jwkelly49/C-MRI-on-Arduino-Cards/16 Input Card/Arduino Code/ReadMe.txt

Drop this folder into Arduino where you store all of your other ino files. Remember you'll have to download the CMRI and Auto485 libraries to make the file compiled and download.

https://github.com/madleech/Auto485

https://github.com/madleech/ArduinoCMRI

this is a good HELP for installing arduino libraries
https://www.arduino.cc/en/guide/libraries
