jwkelly49/C-MRI-on-Arduino-Cards/8 input 8 output card/Schematic/8 in 8 out schematic.jpg

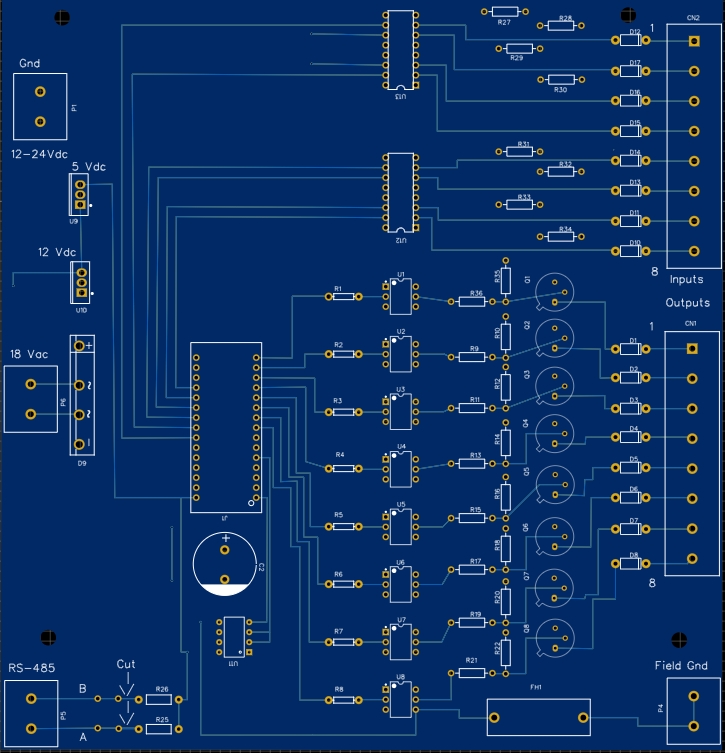
8 input 8 output card/Schematic/8 in 8 out schematic.jpg
