jwkelly49/C-MRI-on-Arduino-Cards/16 Input Card/Schematic/schematic.jpg

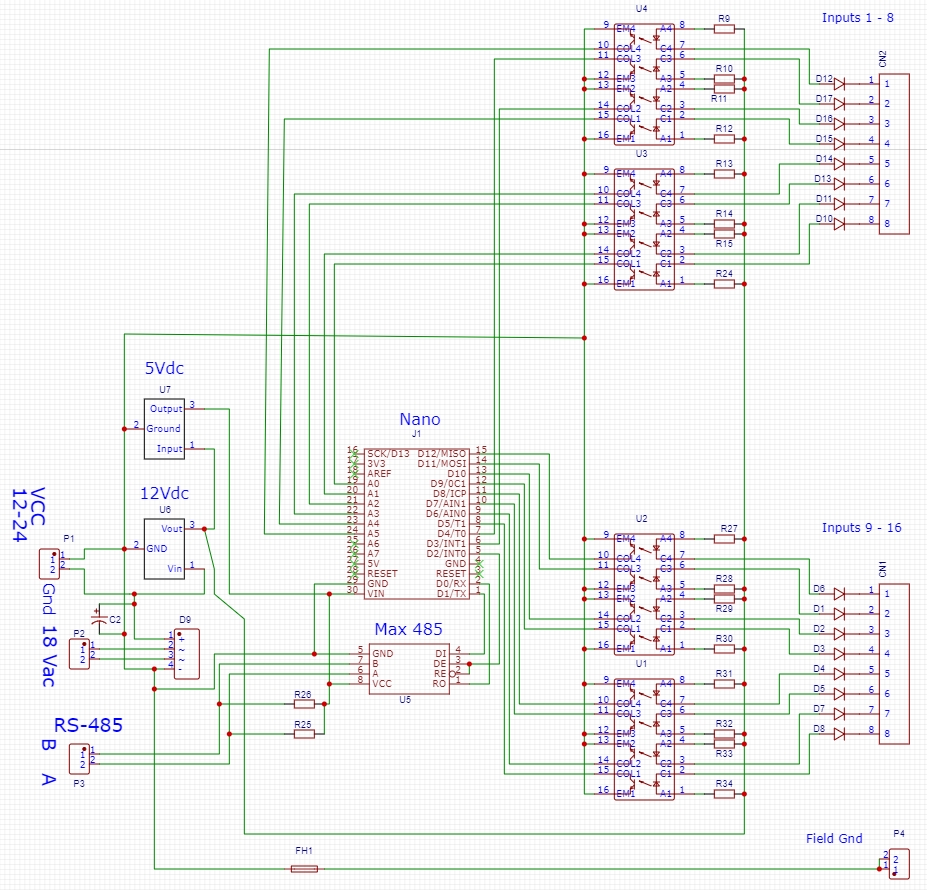
16 Input Card/Schematic/schematic.jpg
