jwkelly49/C-MRI-on-Arduino-Cards/Block Detector/Schematic/block detector.jpg

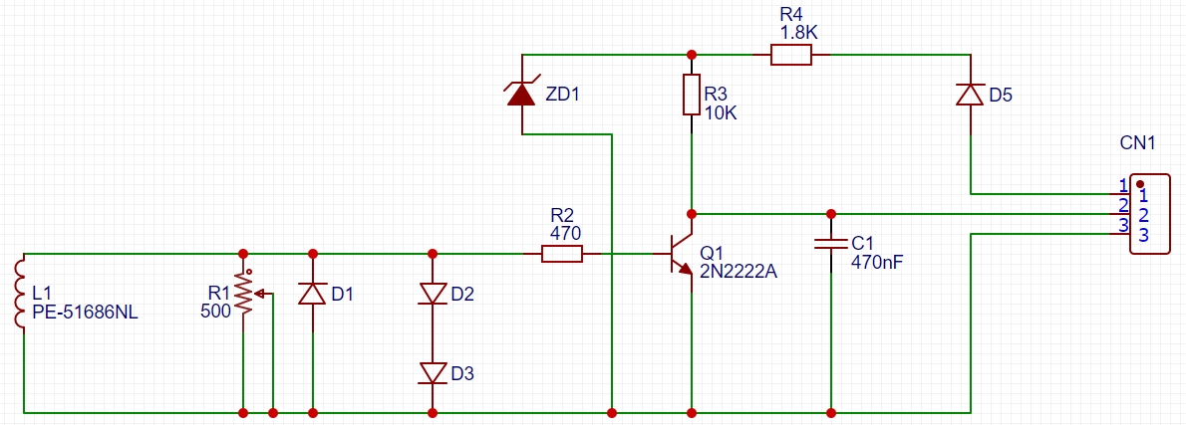
Block Detector/Schematic/block detector.jpg
