jwkelly49/C-MRI-on-Arduino-Cards/Compatible Siding Card/Schematic/pcb 3.jpg

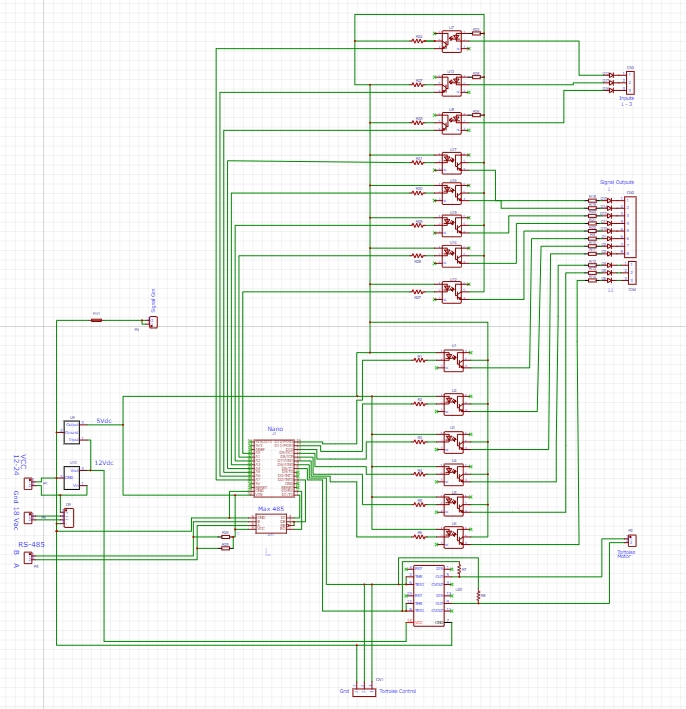
Compatible Siding Card/Schematic/pcb 3.jpg
