jwkelly49/C-MRI-on-Arduino-Cards/holding/power.jpg

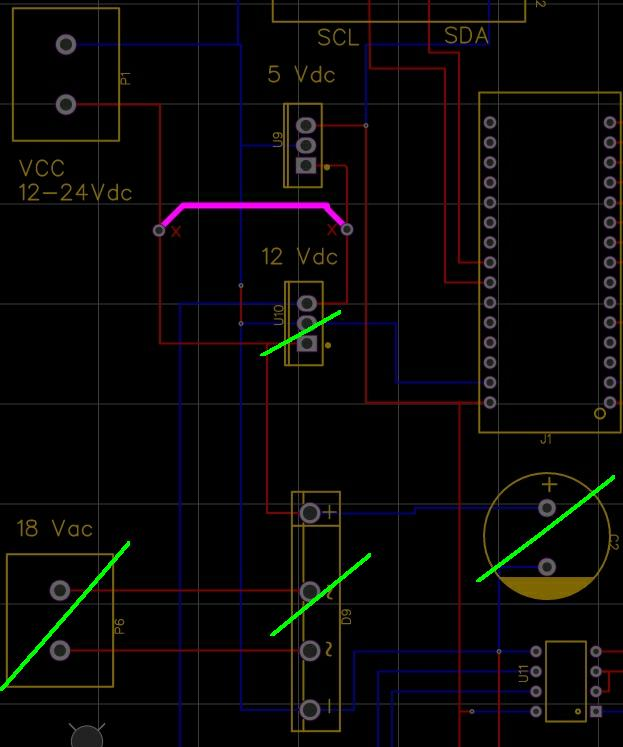
holding/power.jpg
