jwkelly49/C-MRI-on-Arduino-Cards/Tortoise Matrix Setup Card/Schematic/schmatic.jpg

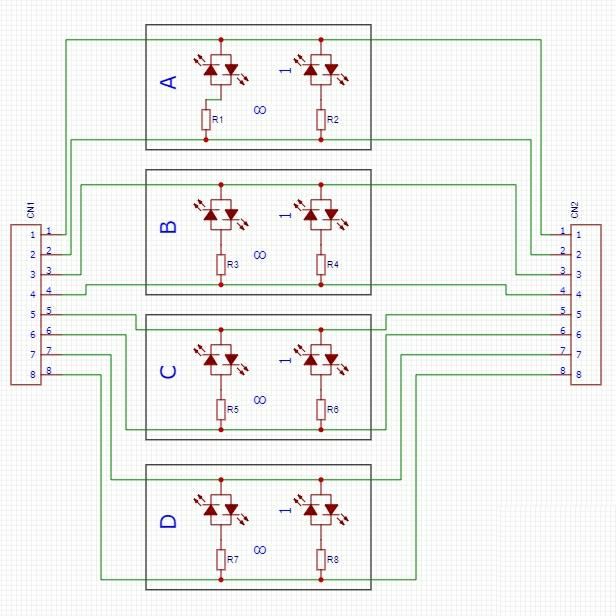
Tortoise Matrix Setup Card/Schematic/schmatic.jpg
