jwkelly49/C-MRI-on-Arduino-Cards/Compatible Siding Card/Printed Circuit Board/BOM_OS Siding Board.csv

ID | Name | Designator | Footprint | Quantity | Manufacturer Part | Manufacturer | Supplier | Supplier Part
1 | 64600001003 | FH1 | FUSE-2P-25.8X9.0 | 1 | 64600001003 | Littelfuse | LCSC | C206887
2 | 1N4001 | D2,D5,D6,D1,D3,D17,D16,D15,D14,D13,D12,D11,D10,D4 | DO-41 | 14 | 1N4001 | DIOFIT | LCSC | C169150
3 | WJ25C-B-7.62-3P-13-00A | CN1,CN4,CN3 | WJ25C-B-7.62-3P | 3 | WJ25C-B-7.62-3P-13-00A | ReliaPro | LCSC | C61583
4 | WJ25C-B-7.62-8P-13-00A | CN2 | WJ25C-B-7.62-8P | 1 | WJ25C-B-7.62-8P-13-00A | ReliaPro | LCSC | C49492
5 | MAX485DIL | U11 | DIP8 | 1
6 | MC7805BTG | U9 | TO-220-3_L10.0-W4.5-P2.54-L | 1 | MC7805BTG | ON | LCSC | C45385
7 | 680 | R4,R5,R3 | RES-TH_BD2.4-L6.3-P10.30-D0.6 | 3 | RD 1/4W 680R J T/B A1 | TyoHM | LCSC | C433698
8 | ILQ2 | U1,U4,U3,U2 | DIP-16_L19.8-W6.5-P2.54-LS7.6-BL | 4 | ILQ2 | VISHAY | LCSC | C145338
9 | CJ7812 | U10 | TO-220-3_L10.0-W4.5-P2.54-L | 1 | CJ7812 | CJ | LCSC | C77894
10 | 150 | R2,R1 | RES-TH_BD2.2-L6.5-P10.50-D0.6 | 2 | CFR0W4J0151A50 | UniOhm | LCSC | C70814
11 | 4.7uF | C1 | CAP-TH_BD4.0-P1.50-D0.8-FD | 1 | 4.7uF 50V 4*7 | ValuePro | LCSC | C43841
12 | 10k | R7,R8 | PKG-0.25W RESISTOR | 2 | RESISTOR_ALONG | MULTICOMP | Element14 | 9339116
13 | 470uF | C2 | CAP-TH_BD16.0-P7.50-D1.2-FD | 1 | 470uF 100V 16*25 | ValuePro | LCSC | C72551
14 | ILD2 | U5 | DIP-8_L9.7-W6.4-P2.54-LS7.6-BL | 1 | ILD2 | VISHAY | LCSC | C10612
15 | 390 | R17,R16,R14,R13,R18,R12,R11,R10,R15,R9,R6 | RES-TH_BD2.4-L6.3-P10.30-D0.6 | 11 | RD 1/4W 390R J T/B A1 | TyoHM | LCSC | C433722
16 | 10K | R25,R26 | AXIAL-0.4 | 2 | CFR0W4J0103A50 | UniOhm | LCSC | C61299
17 | LM556CN | U20 | DIP14 | 1 | ?
18 | WJ25C-B-2P | P5,P2,P1,P6,P4 | CONN-TH_2P-P7.62_WJ25C-B-7.62-2P | 5 | WJ25C-B-2P | ReliaPro | LCSC | C8422
19 | D50SB100 | D9 | DIO-BG-TH_DXXSBXX | 1 | D50SB100 | Leshan Radio | LCSC | C411148
20 | Arduino_Nano_Header | J1 | DIP-30_L43.18-W15.24-ARDUINONANO | 1
