jwkelly49/C-MRI-on-Arduino-Cards/Tortoise Matrix Setup Card/Printed Circuit Board/BOM_Tortoise Matrix Setup Board.csv

ID | Name | Designator | Footprint | Quantity | Manufacturer Part | Manufacturer | Supplier | Supplier Part
1 | 270 | R1,R2,R3,R4,R5,R6,R7,R8 | AXIAL-7.1X2.3(1/2W) | 8 | MFS1/2CCT52A2700F | KOA Speer Elec | LCSC | C202436
2 | WJ25C-B-7.62-8P-13-00A | CN1,CN2 | WJ25C-B-7.62-8P | 2 | WJ25C-B-7.62-8P-13-00A | ReliaPro | LCSC | C49492
3 | LTL-293SJW | LED1,LED2,LED3,LED4,LED5,LED6,LED7,LED8 | LED-5MM/2.54 | 8 | LTL-293SJW | LITEON | LCSC | C125079
