jwkelly49/C-MRI-on-Arduino-Cards/16 Input Card/Printed Circuit Board/ReadMe.txt

The bill of materials (BOM) file may have a few holes but it should give you a good idea of the parts needed. The supplier is LCSC ( https://lcsc.com/en ) which is integrated into the EasyEDA program. A few parts were ordered from Newark ( https://www.newark.com/ )

The Gerber file can be sent directly to JLCPCB, also integrated into EasyEDA ( https://jlcpcb.com/ ), to order the PCB without changes.

The 2 json files can be imported directly into EasyEDA ( https://easyeda.com/ ) and then modified as desired.
