jwkelly49/C-MRI-on-Arduino-Cards/Tortoise Matrix Setup Card/Arduino Code/ReadMe.txt

There is no code associated with this card.
