jwkelly49/C-MRI-on-Arduino-Cards/Tortoise Matrix Setup Card/JMRI Configuration Profile/ReadMe.txt

This card does not need a JMRI configuration profile.
