jwkelly49/C-MRI-on-Arduino-Cards/8 input 8 output card/Printed Circuit Board/8 inputs 8 outputs Card.jpg

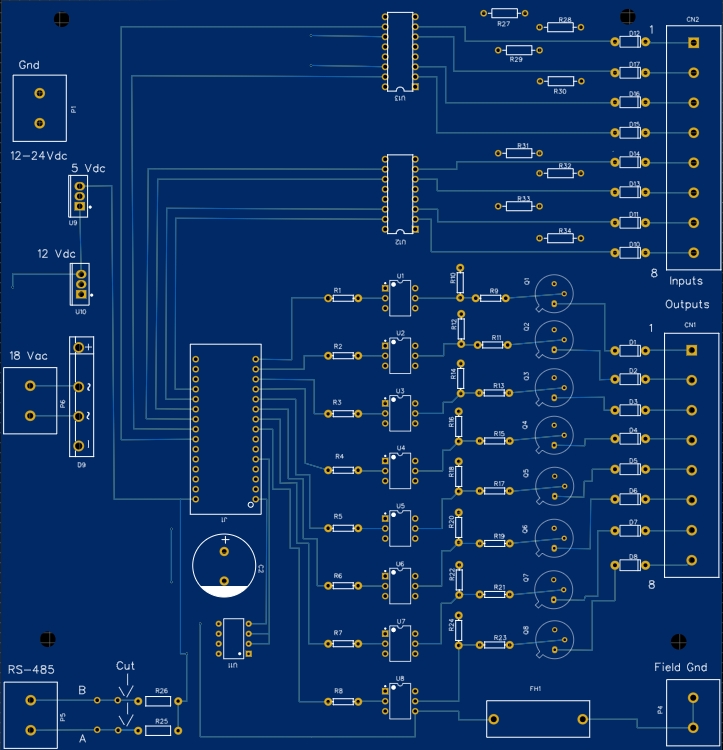
8 input 8 output card/Printed Circuit Board/8 inputs 8 outputs Card.jpg
