jwkelly49/C-MRI-on-Arduino-Cards/8 Inputs with I2C Card/Printed Circuit Board/8 inputs with I2C Card.jpg

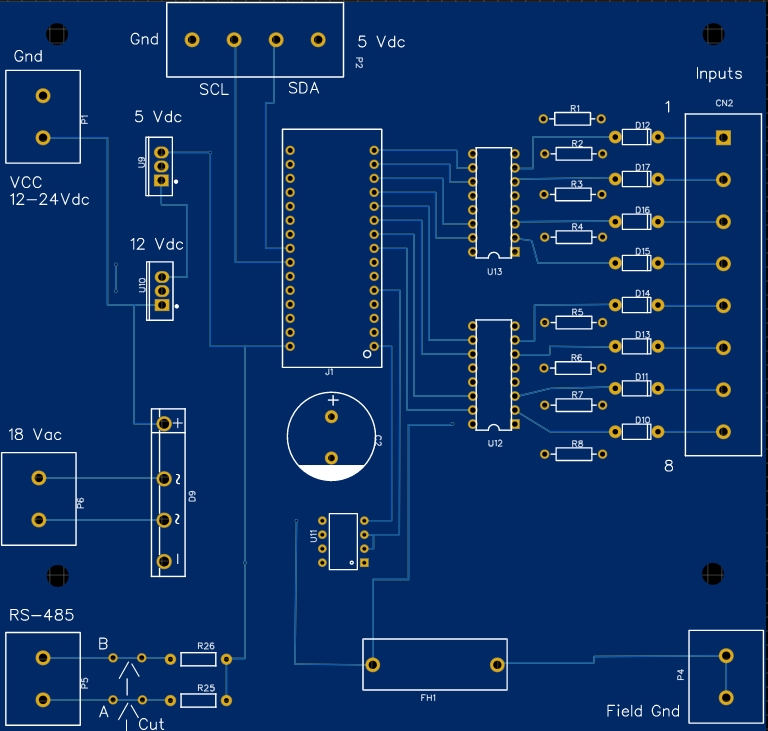
8 Inputs with I2C Card/Printed Circuit Board/8 inputs with I2C Card.jpg
