jwkelly49/C-MRI-on-Arduino-Cards/8 outputs with I2C Card/Printed Circuit Board/8 outputs with I2C Card.jpg

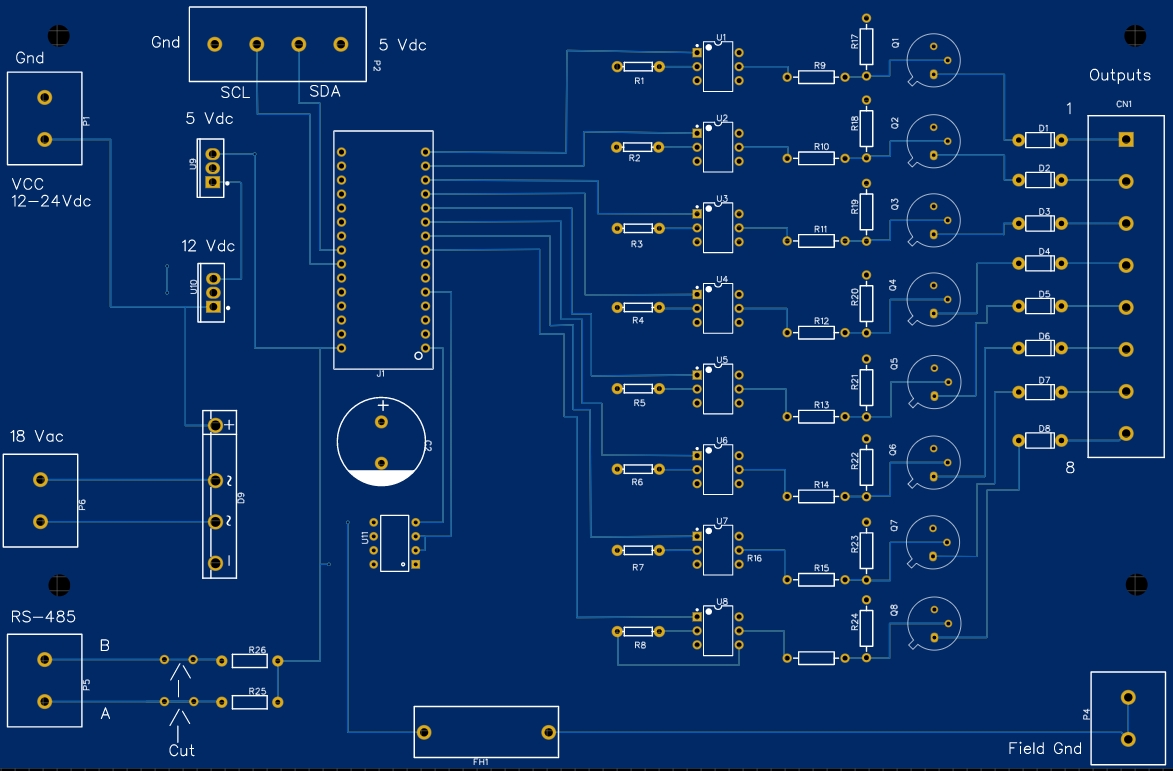
8 outputs with I2C Card/Printed Circuit Board/8 outputs with I2C Card.jpg
