jwkelly49/C-MRI-on-Arduino-Cards/16 Input Card/Printed Circuit Board/16 input card.jpg

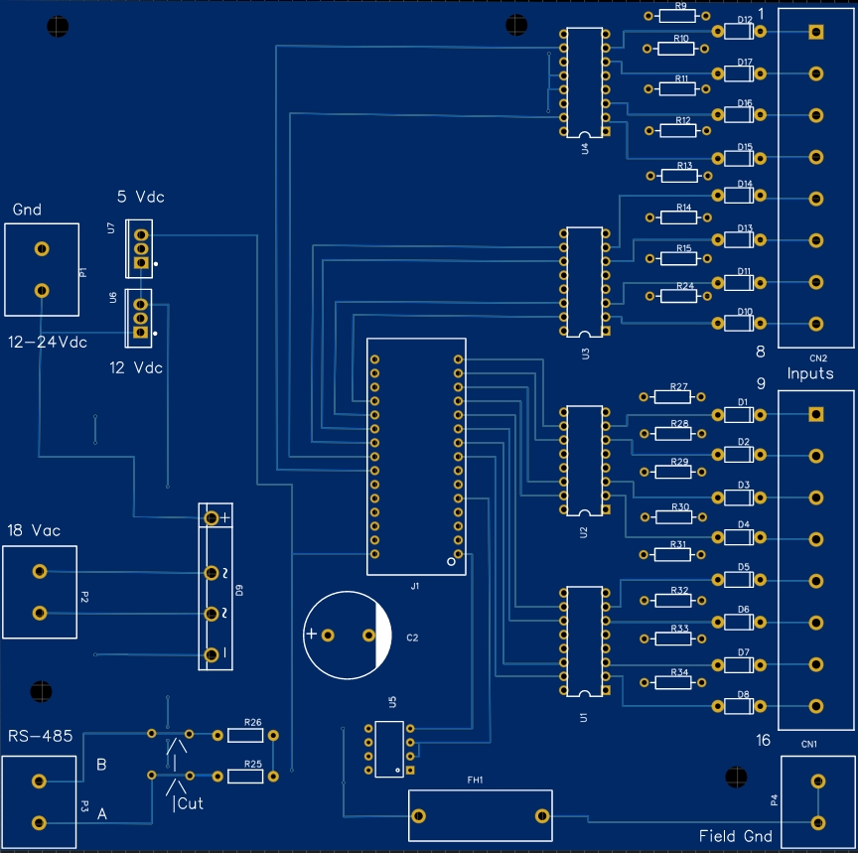
16 Input Card/Printed Circuit Board/16 input card.jpg
