jwkelly49/C-MRI-on-Arduino-Cards/Block Detector/Printed Circuit Board/block detector board.jpg

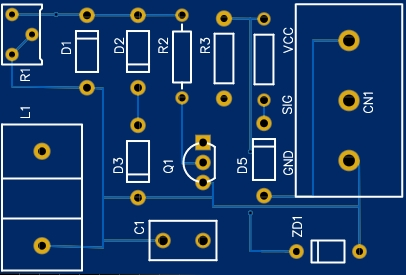
Block Detector/Printed Circuit Board/block detector board.jpg
