jwkelly49/C-MRI-on-Arduino-Cards/Compatible Siding Card/Printed Circuit Board/OS siding Board Card.jpg

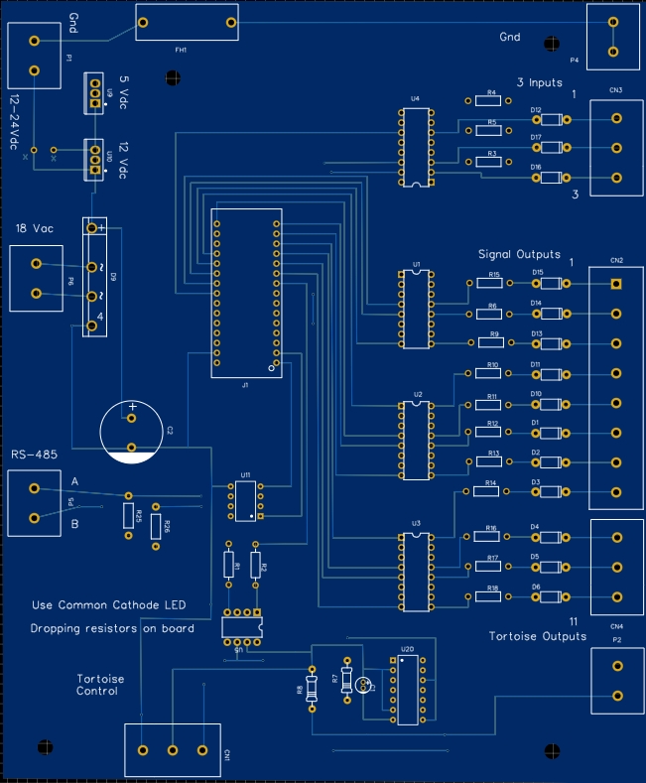
Compatible Siding Card/Printed Circuit Board/OS siding Board Card.jpg
