jwkelly49/C-MRI-on-Arduino-Cards/Tortoise No Routing Matrix Card/Printed Circuit Board/tortoise no matrix card.jpg

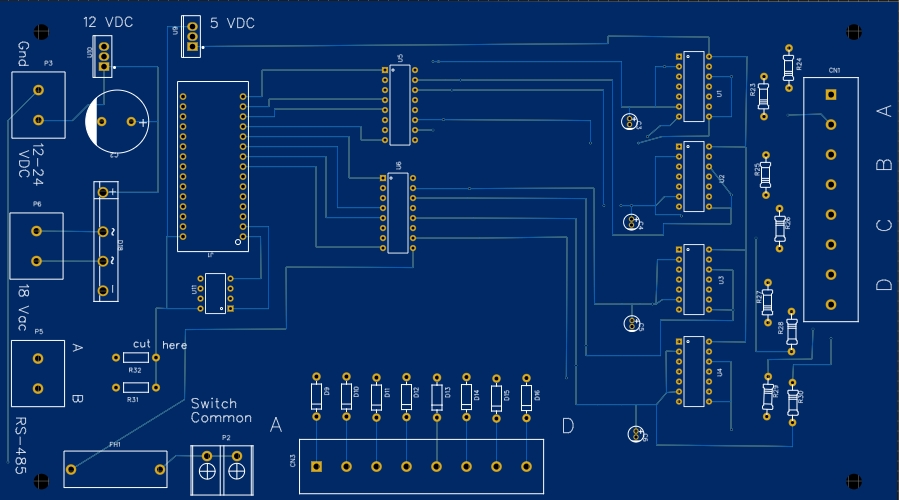
Tortoise No Routing Matrix Card/Printed Circuit Board/tortoise no matrix card.jpg
