jwkelly49/C-MRI-on-Arduino-Cards/Tortoise with Routing Matrix Card/Printed Circuit Board/Tortoise with Matrix Routing Card.jpg

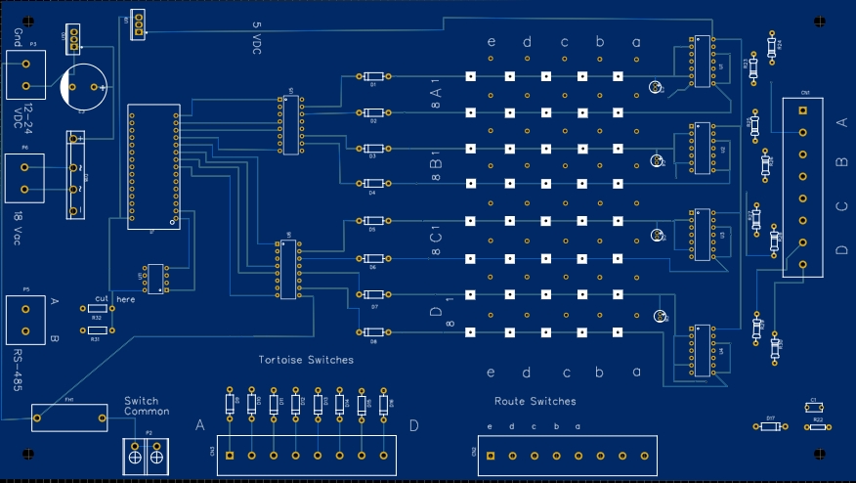
Tortoise with Routing Matrix Card/Printed Circuit Board/Tortoise with Matrix Routing Card.jpg
