jwkelly49/C-MRI-on-Arduino-Cards/Tortoise Matrix Setup Card/Printed Circuit Board/Tortoise test Board.jpg

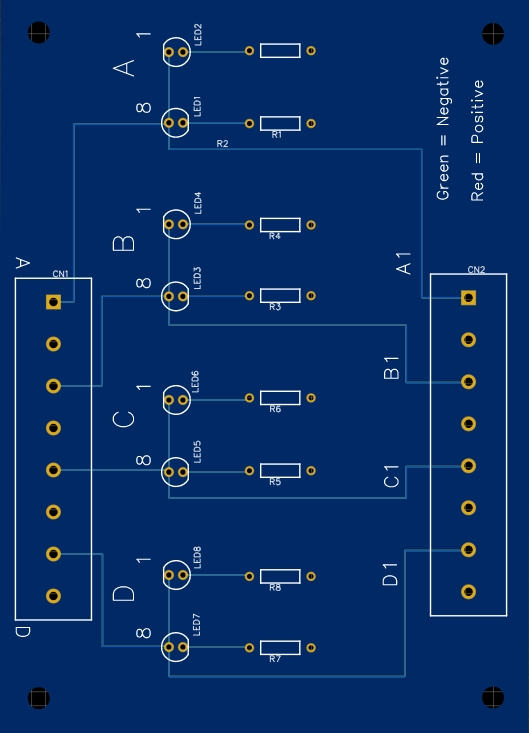
Tortoise Matrix Setup Card/Printed Circuit Board/Tortoise test Board.jpg
