jwkelly49/C-MRI-on-Arduino-Cards/(commit log)

2020-06-15 board jpg files
2020-06-16 still uploading
    [BOM_16 Inputs Card.csv, BOM_8 Inputs + 8 Outputs Card.csv, BOM_8 Inputs Card with I2C.csv, BOM_8 Outputs Card with _I2C.csv, BOM_OS Siding Board.csv, BOM_block detector.csv]
2020-06-16 more upload
    [BOM_Tortoise Matrix Setup Board.csv, BOM_Tortoise No Routing Matrix Card.csv, BOM_Tortoise with Routing Matrix Card.csv]
2020-06-24 output updates
    [BOM_8 Inputs + 8 Outputs Card.csv, BOM_8 Outputs Card with _I2C.csv]
2020-07-05 Create power.jpg
    hold for future release
2020-07-05 Create nte1936.pdf
    2 amp regulator
2020-08-21 changed resistors
    Changed resistor size
    [BOM_OS Siding Board.csv]
